oseiskar/CE-inertial/PCBs/design-files/RPi-Pico/pico_extension_v1_1.png

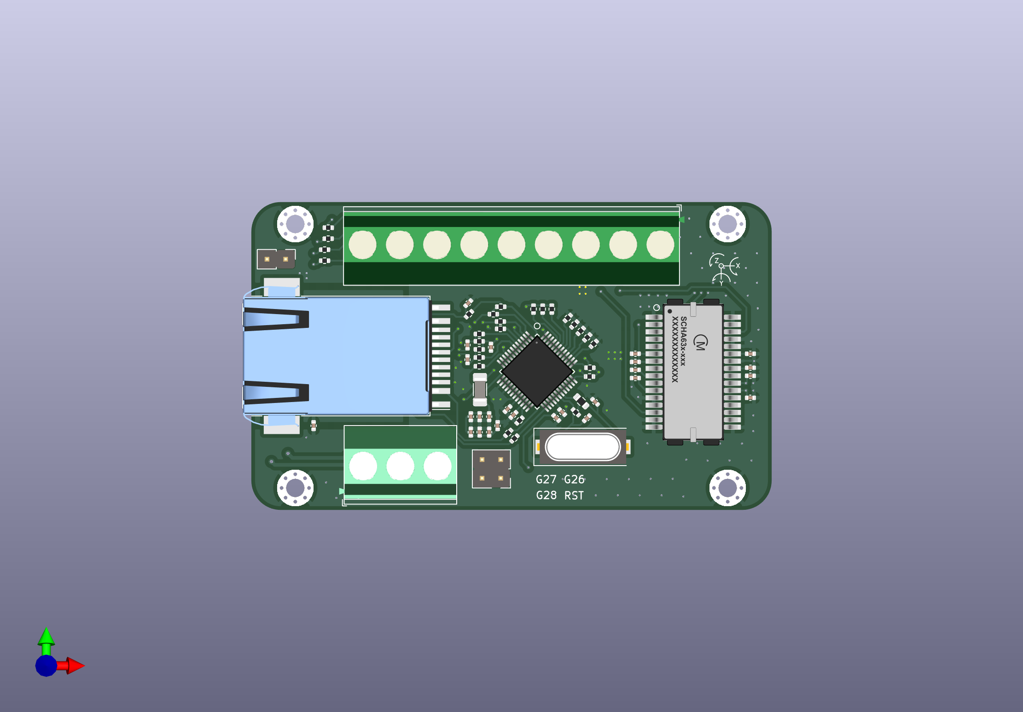
PCBs/design-files/RPi-Pico/pico_extension_v1_1.png
