oseiskar/CE-inertial/drivers/README.md

# Murata SCHA6XX drivers

Implementations for Arduino and RPi Pico platforms
