oseiskar/CE-inertial/PCBs/README.md

# Inertial Module PCBs

NOTE: designs have not been proven to work and should be checked before ordering prototypes. 

Design files and libraries required for two Raspberry Pico implementations.
