oseiskar/CE-inertial/drivers/arduino/README.md

# Murata SCHA63x driver for Arduino

Simple driver for the Murata SCHA63X series of IMUs for the Arduino board. The full data sheet for the sensor can be requested from [Murata](https://www.murata.com/en-global/products/sensor/gyro/overview/lineup/scha63t). SPI is used for communication between the sensor and the Arduino board. The carrier PCB documentation is available [here](https://www.murata.com/-/media/webrenewal/products/sensor/pdf/specification/scha600_series_chip-carrier_pcb_specification.ashx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). 

## Resources

* [Arduino SPI Library & example](https://www.arduino.cc/en/reference/SPI)
* [InvenSense ICM-20948 example](https://github.com/sparkfun/SparkFun_ICM-20948_ArduinoLibrary)
