oseiskar/CE-inertial/drivers/pico/scha-driver/README.md

# Pico SCHA6XX Driver

Ethernet communication and protocolbuffer code not included
