oseiskar/CE-inertial/PCBs/custom/ethernet/cetus/J1B1211CCD.step

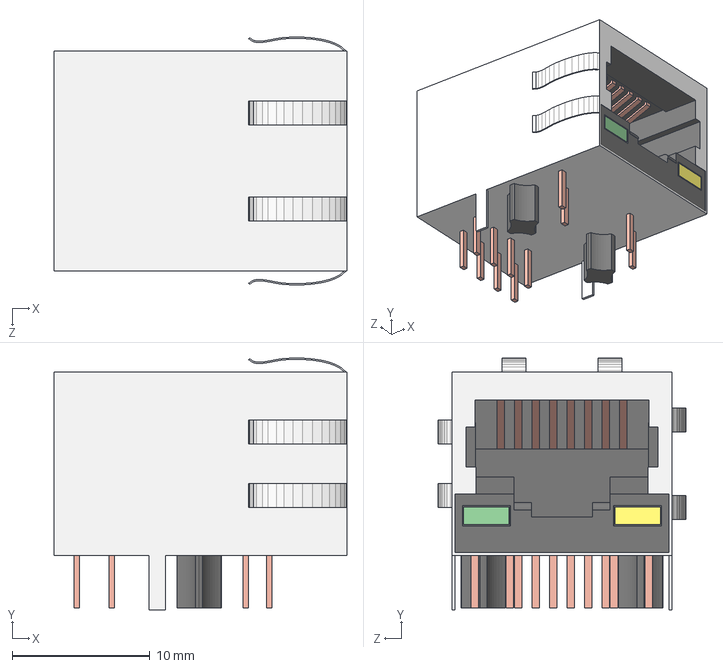
[picture p2: CAD file, 2022-09-22]
PCBs/custom/ethernet/cetus/J1B1211CCD.step
21.3 x 18.3 x 18.0 mm
