oseiskar/CE-inertial/PCBs/custom/ethernet/wiznet/wiznet/Wiznet_W5500.stp

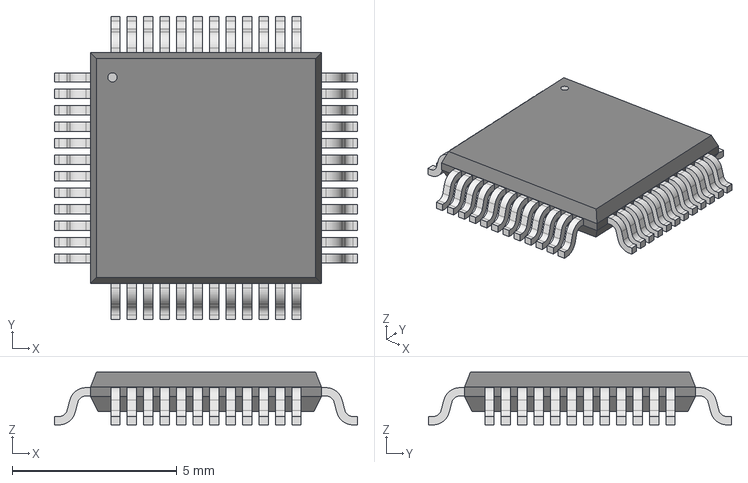
[picture p3: CAD file, 2022-09-22]
PCBs/custom/ethernet/wiznet/wiznet/Wiznet_W5500.stp
9.19 x 9.19 x 1.60 mm
