oseiskar/CE-inertial/PCBs/custom/ethernet/wuerth/wuerth/Wuerth_74980111211.stp

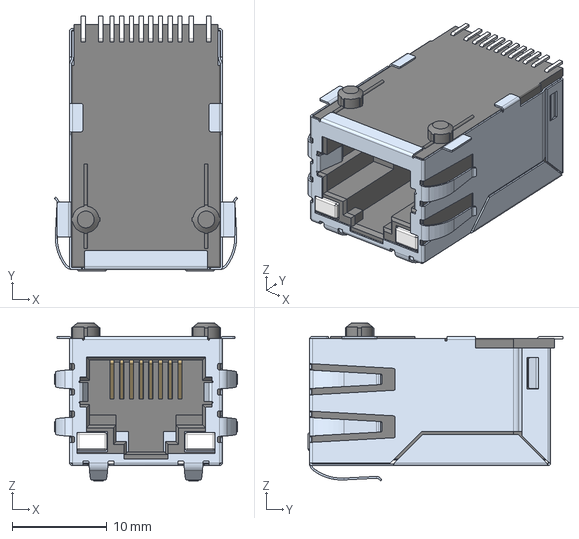
[picture p4: CAD file, 2022-09-22]
PCBs/custom/ethernet/wuerth/wuerth/Wuerth_74980111211.stp
19.3 x 26.9 x 16.6 mm
Insulator x 3
shielding
