oseiskar/CE-inertial/PCBs/custom/murata/murata/scha.step

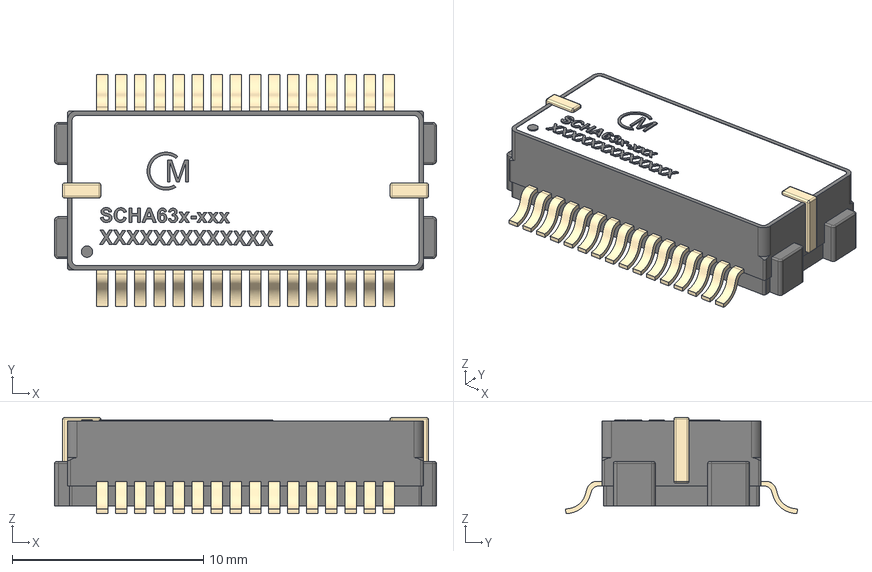
[picture p6: CAD file, 2022-09-22]
PCBs/custom/murata/murata/scha.step
20.0 x 12.2 x 5.05 mm
imu_body
feet
front_plate
graphicst
