oseiskar/CE-inertial/PCBs/custom/terminal/TerminalBlock_Phoenix_MKDS-1,5-3-5.08_1x03_P5.08mm_Horizontal.step

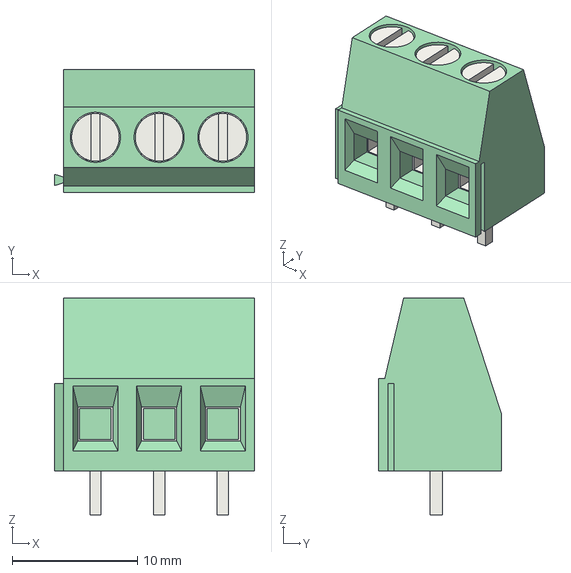
[picture p7: CAD file, 2022-09-22]
PCBs/custom/terminal/TerminalBlock_Phoenix_MKDS-1,5-3-5.08_1x03_P5.08mm_Horizontal.step
16.0 x 9.80 x 17.3 mm
