oseiskar/CE-inertial/PCBs/custom/mcu/w5500-pico-evb/PinHeader_1x06_P2.54mm_Vertical.step

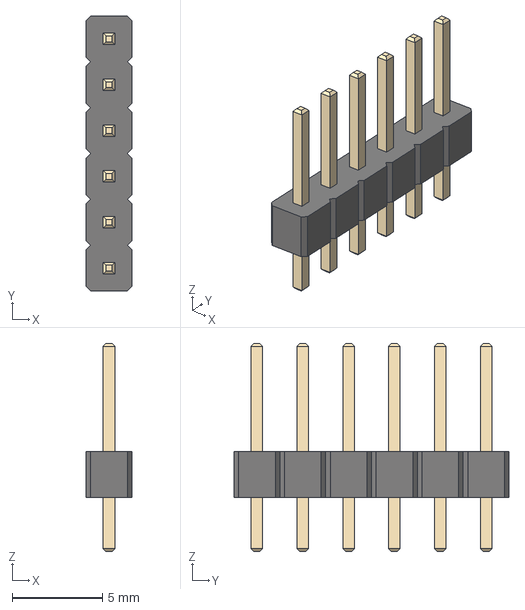
[picture p8: CAD file, 2022-09-22]
PCBs/custom/mcu/w5500-pico-evb/PinHeader_1x06_P2.54mm_Vertical.step
2.54 x 15.2 x 11.5 mm
