oseiskar/CE-inertial/PCBs/custom/terminal/TerminalBlock_Phoenix_MKDS-1,5-9-5.08_1x09_P5.08mm_Horizontal.step

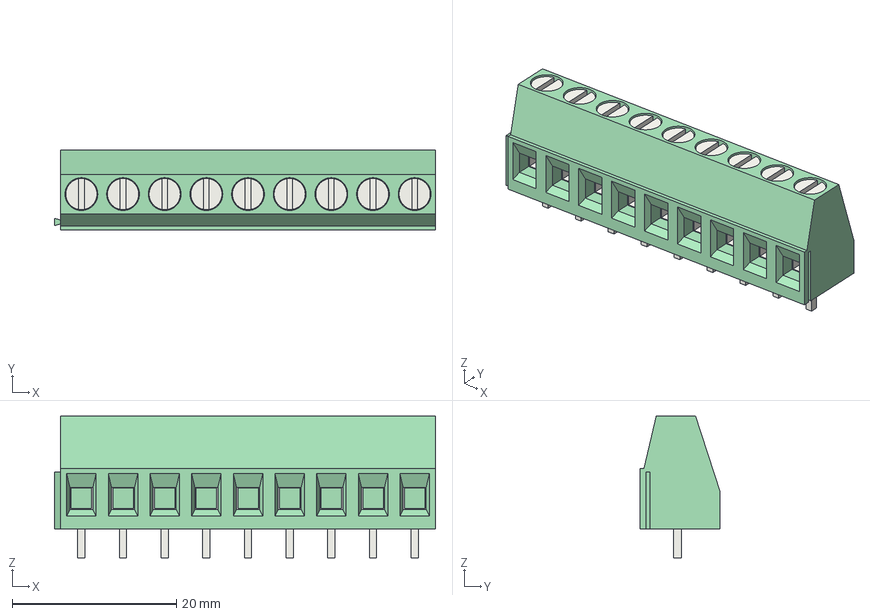
[picture p9: CAD file, 2022-09-22]
PCBs/custom/terminal/TerminalBlock_Phoenix_MKDS-1,5-9-5.08_1x09_P5.08mm_Horizontal.step
46.5 x 9.80 x 17.3 mm
