oseiskar/CE-inertial/PCBs/custom/mcu/w5500-pico-evb/pico.step

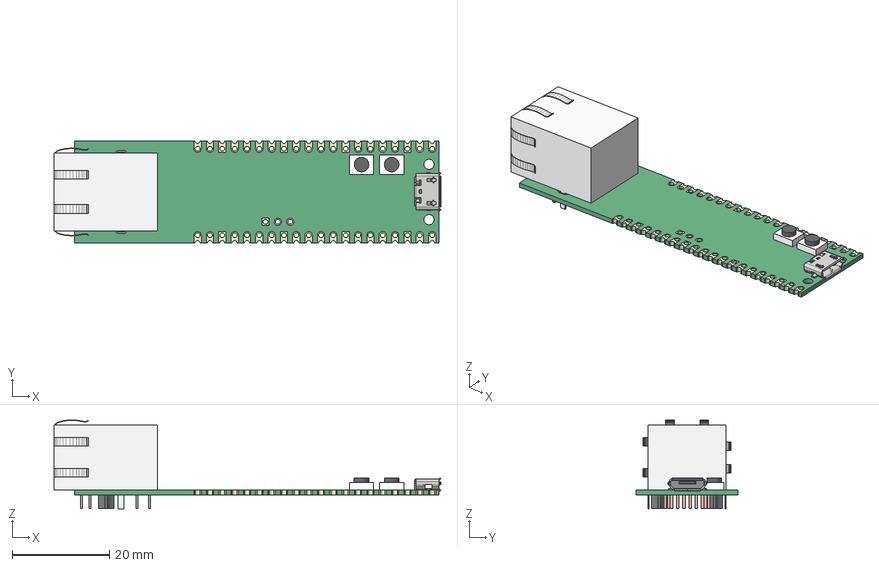
[picture p10: CAD file, 2022-09-22]
PCBs/custom/mcu/w5500-pico-evb/pico.step
79.6 x 21.0 x 18.3 mm
pins
J1B1211CCD
molex_0473460001
buttons
board
