oseiskar/CE-inertial/PCBs/custom/mcu/w5500-pico-evb/PinHeader_1x20_P2.54mm_Vertical.step

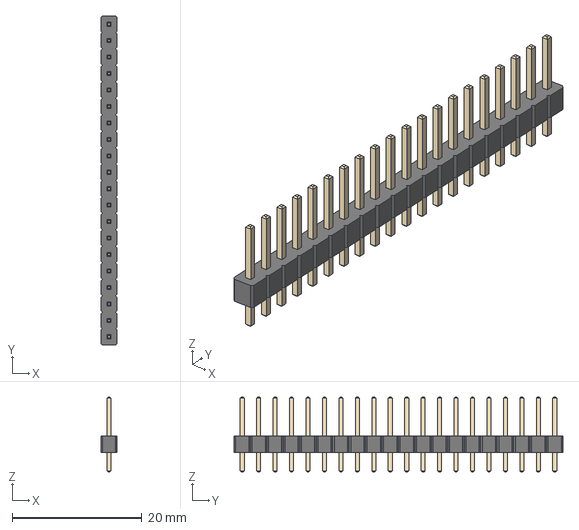
[picture p11: CAD file, 2022-09-22]
PCBs/custom/mcu/w5500-pico-evb/PinHeader_1x20_P2.54mm_Vertical.step
2.54 x 50.8 x 11.5 mm
