oseiskar/CE-inertial/(list of files, cad)

Other CAD files:
PCBs/custom/mcu/w5500-pico-evb/pico_evb.step
PCBs/custom/murata/murata/scha_.step
