oseiskar/CE-inertial/PCBs/schema/W5500-Pico.pdf

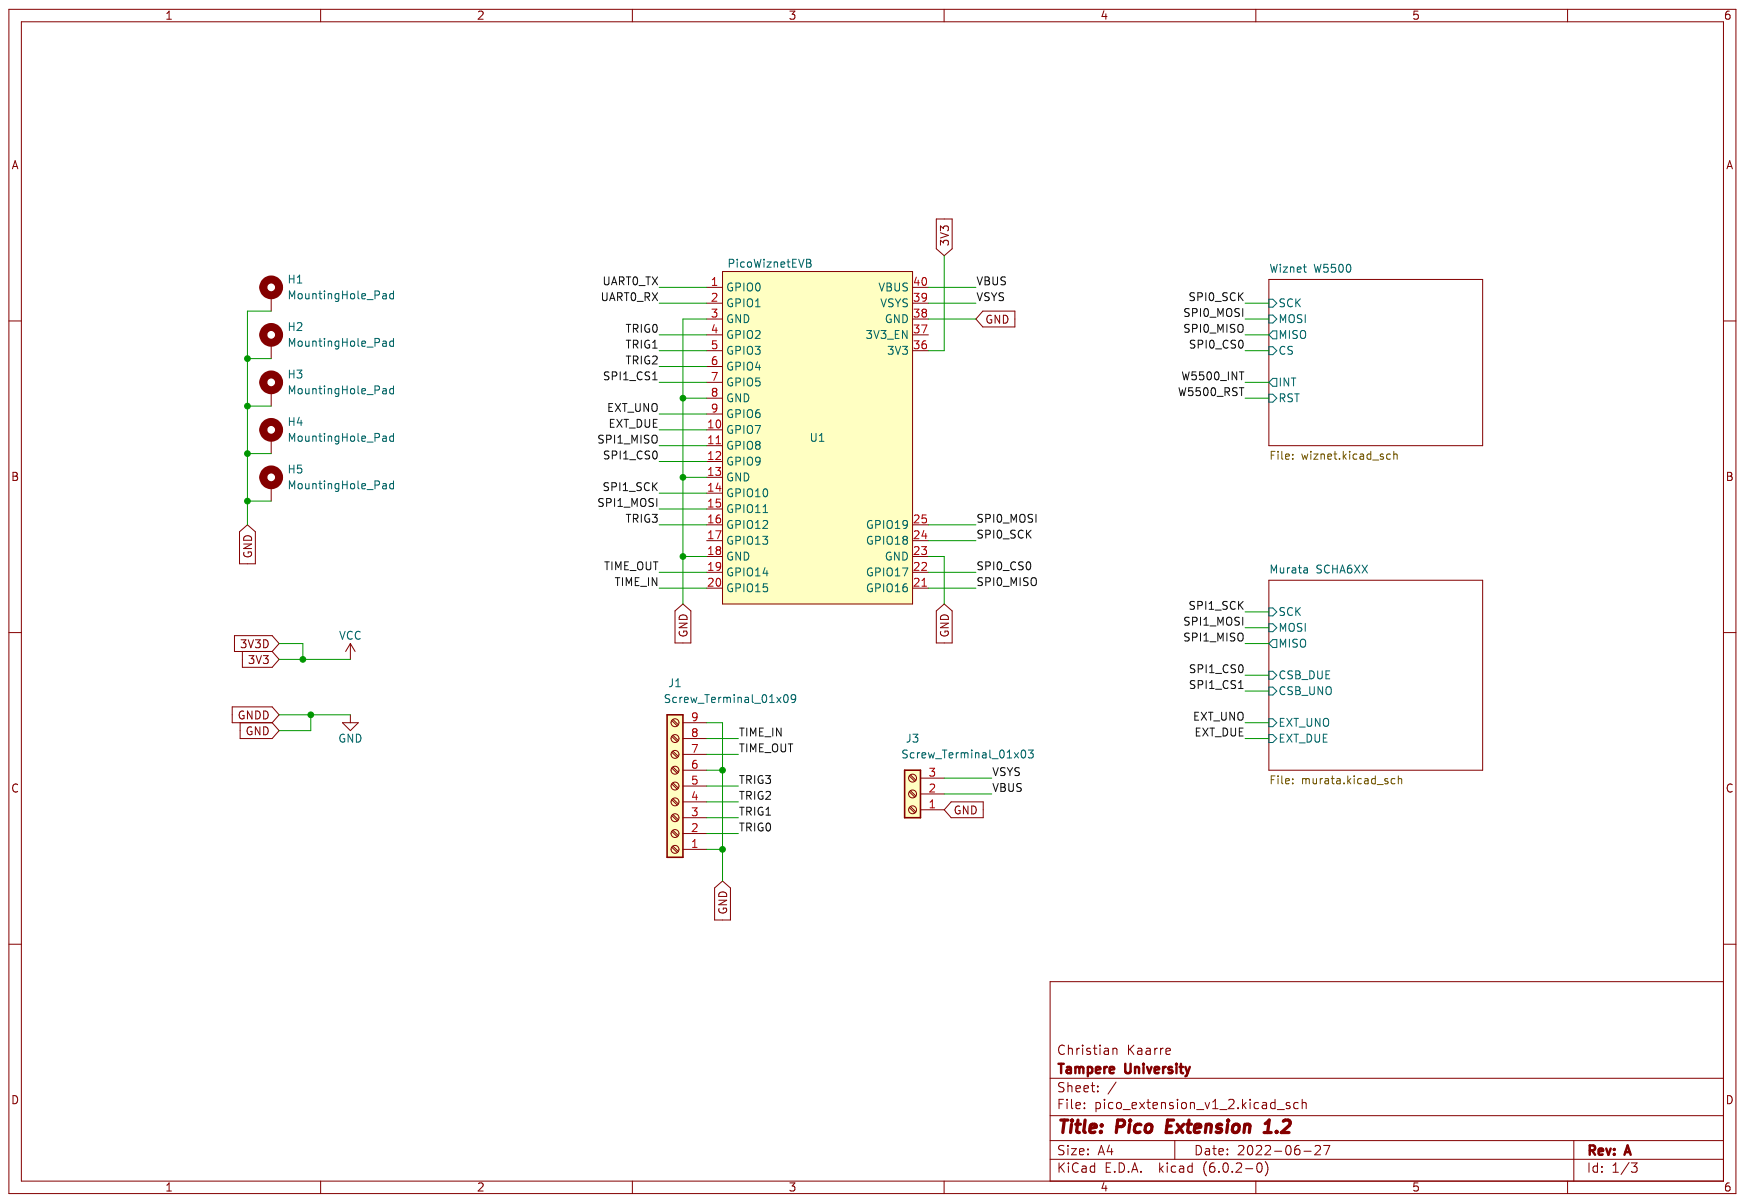
[picture p15: page 1]

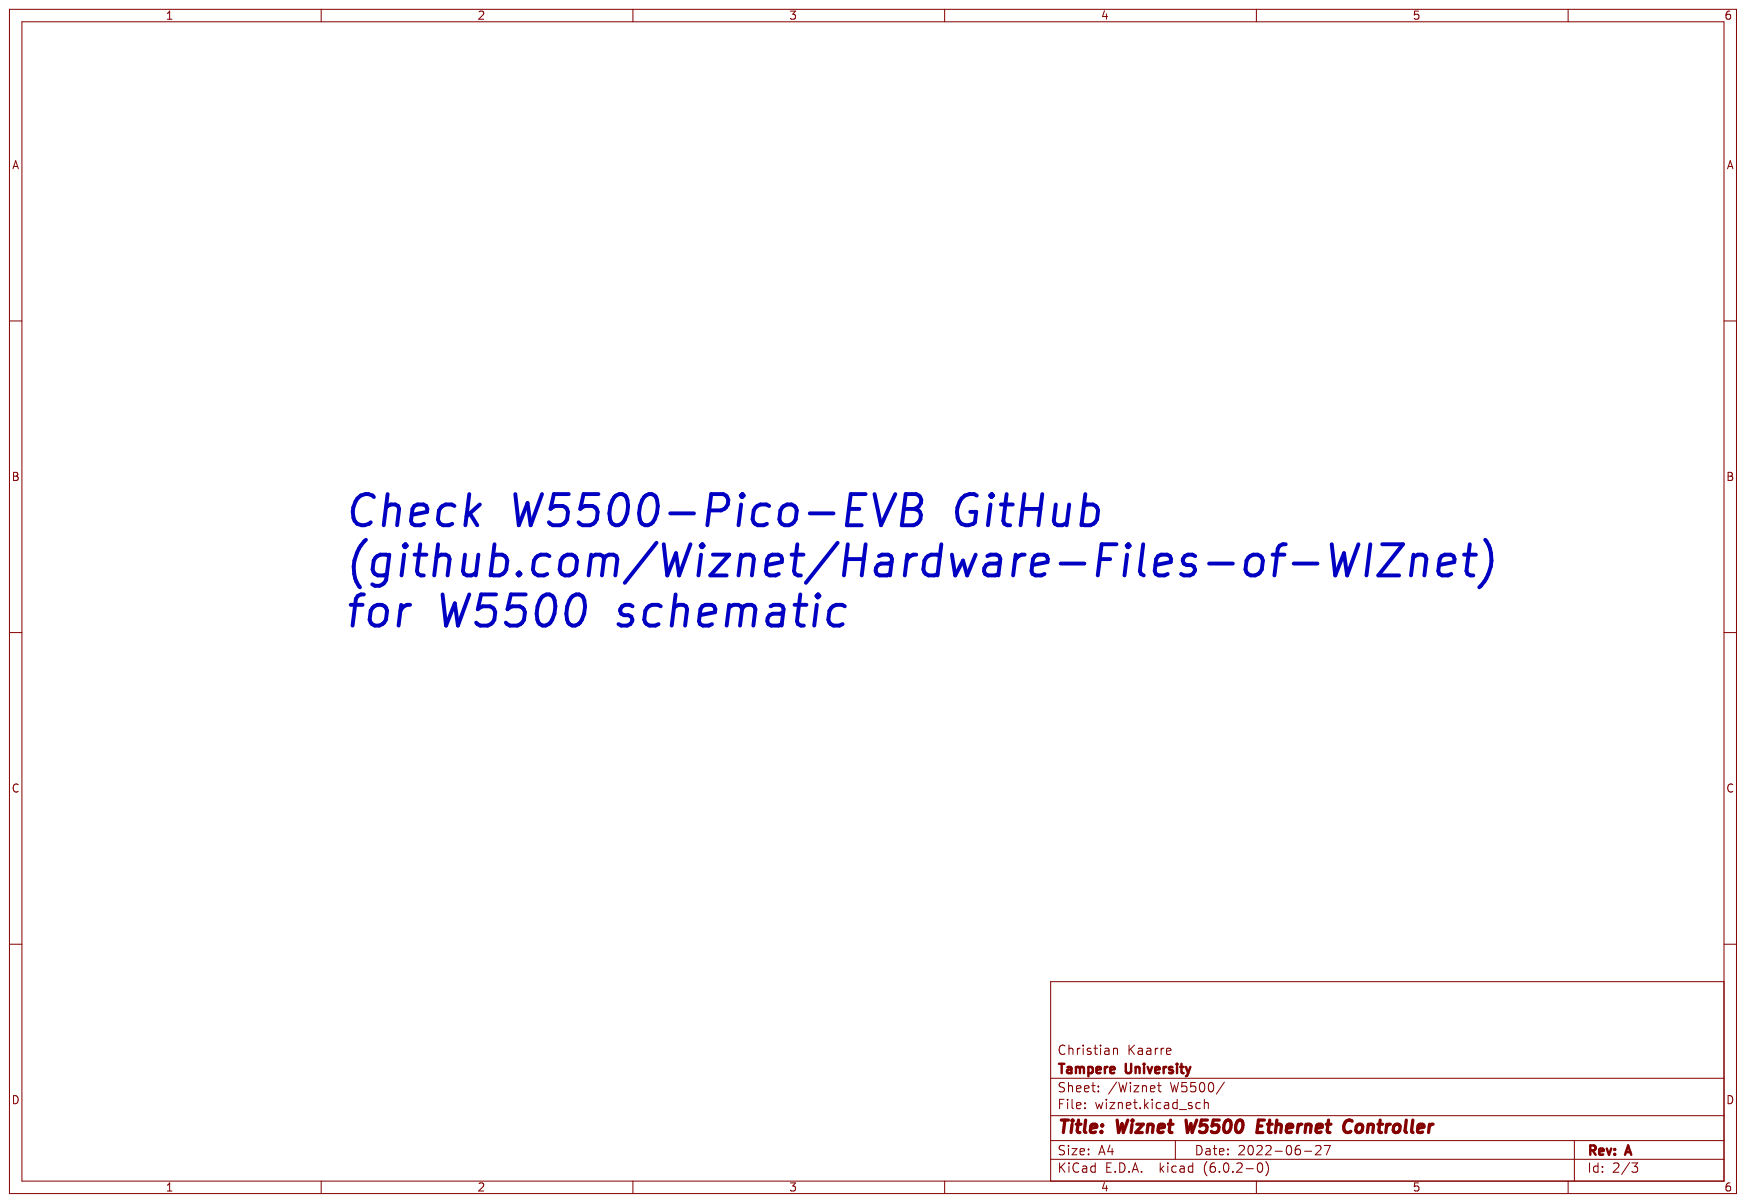
[picture p16: page 2]
