oseiskar/CE-inertial/PCBs/design-files/W5500-Pico/pico_extension_v1_2.kicad_pcb

## KiCad design PCBs/design-files/W5500-Pico/pico_extension_v1_2.kicad_pcb (2022-09-22)

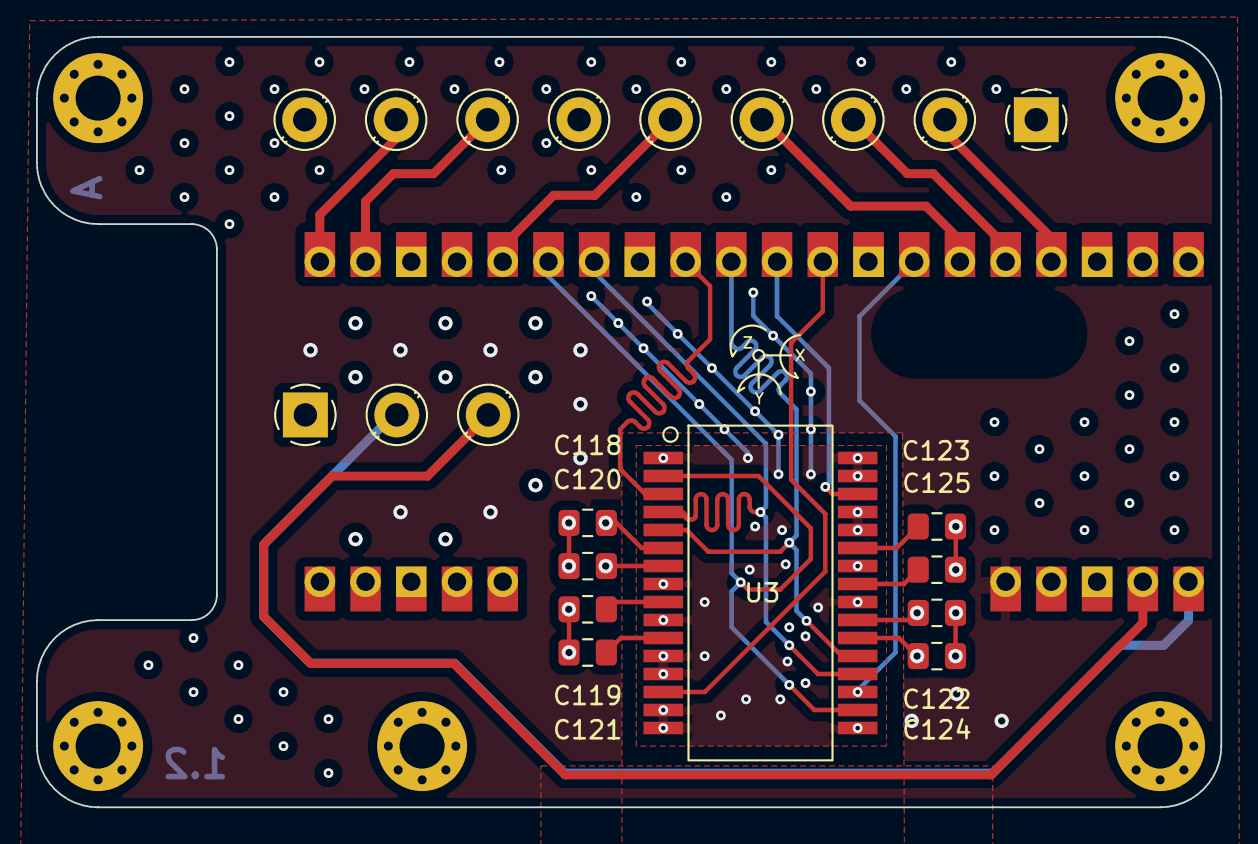
[picture p17: board pico_extension_v1_2.kicad_pcb from above]

Board: 4 copper layers, 65.8 x 42.8 mm, 17 parts (0 on the bottom side), 21 nets.

Parts:
C118, C119, C121, C122, C123, C125: 1uF; C_0805_2012Metric_Pad1.18x1.45mm_HandSolder
C120, C124: 100nF; C_0805_2012Metric_Pad1.18x1.45mm_HandSolder
H1, H2, H3, H4, H5: MountingHole_Pad; MountingHole_2.5mm_Pad_Via
J1: Screw_Terminal_01x09; TerminalBlock_RND_205-00294_1x09_P5.08mm_Horizontal
J3: Screw_Terminal_01x03; TerminalBlock_RND_205-00288_1x03_P5.08mm_Horizontal
U1: PicoWiznetEVB; pico-w5500-evb-limited_pins
U3: SCHA63X; murata_scha

Connections:
3V3: C118.1, C120.1, C122.1, C124.1, U1.36 (3V3), U3.6 (DUE_V3p3D), U3.7 (DUE_V3p3A), U3.22 (UNO_V3p3D), U3.23 (UNO_V3p3A)
/EXT_DUE: U1.10 (GPIO7), U3.30 (DUE_TI/EXTERN)
/EXT_UNO: U1.9 (GPIO6), U3.14 (UNO_TI/EXTERN)
/SPI1_CS0: U1.12 (GPIO9), U3.3 (DUE_CSB)
/SPI1_CS1: U1.7 (GPIO5), U3.19 (UNO_CSB)
/SPI1_MISO: U1.11 (GPIO8), U3.5 (DUE_MISO), U3.21 (UNO_MISO)
/SPI1_MOSI: U1.15 (GPIO11), U3.2 (DUE_MOSI), U3.18 (UNO_MOSI)
/SPI1_SCK: U1.14 (GPIO10), U3.4 (DUE_SCK), U3.20 (UNO_SCK)
/TIME_IN: J1.8, U1.20 (GPIO15)
/TIME_OUT: J1.7, U1.19 (GPIO14)
/TRIG0: J1.2, U1.4 (GPIO2)
/TRIG1: J1.3, U1.5 (GPIO3)
/TRIG2: J1.4, U1.6 (GPIO4)
/TRIG3: J1.5, U1.16 (GPIO12)
/VBUS: J3.2, U1.40 (VBUS)
/VSYS: J3.3, U1.39 (VSYS)
GND: C118.2, C119.1, C120.2, C121.1, C122.2, C123.2, C124.2, C125.2, H1.1, H2.1, H3.1, H4.1, H5.1, J1.1, J1.6, J1.9, J3.1, U1.3 (GND), U1.8 (GND), U1.13 (GND), U1.18 (GND), U1.23 (GND), U1.38 (GND), U3.1 (EMC_GND), U3.8 (DUE_GNDD), U3.10 (UNO_GNDA/EMC_GND), U3.12 (RESERVED), U3.13 (UNO_TIOP), U3.15 (UNO_TION), U3.16 (EMC_GND), U3.17 (EMC_GND), U3.24 (UNO_GNDD), U3.26 (DUE_GNDA/EMC_GND), U3.28 (DUE_RESERVED), U3.29 (DUE_TIOP), U3.31 (DUE_TION), U3.32 (EMC_GND)
unnamed: C119.2, U3.9 (DUE_VDDD)
unnamed: C121.2, U3.11 (UNO_VDDA)
unnamed: C123.1, U3.27 (DUE_VDDA)
unnamed: C125.1, U3.25 (UNO_VDDD)
