oseiskar/CE-inertial/PCBs/design-files/RPi-Pico/pico_extension_v1_1.kicad_pcb

## KiCad design PCBs/design-files/RPi-Pico/pico_extension_v1_1.kicad_pcb (2022-09-22)

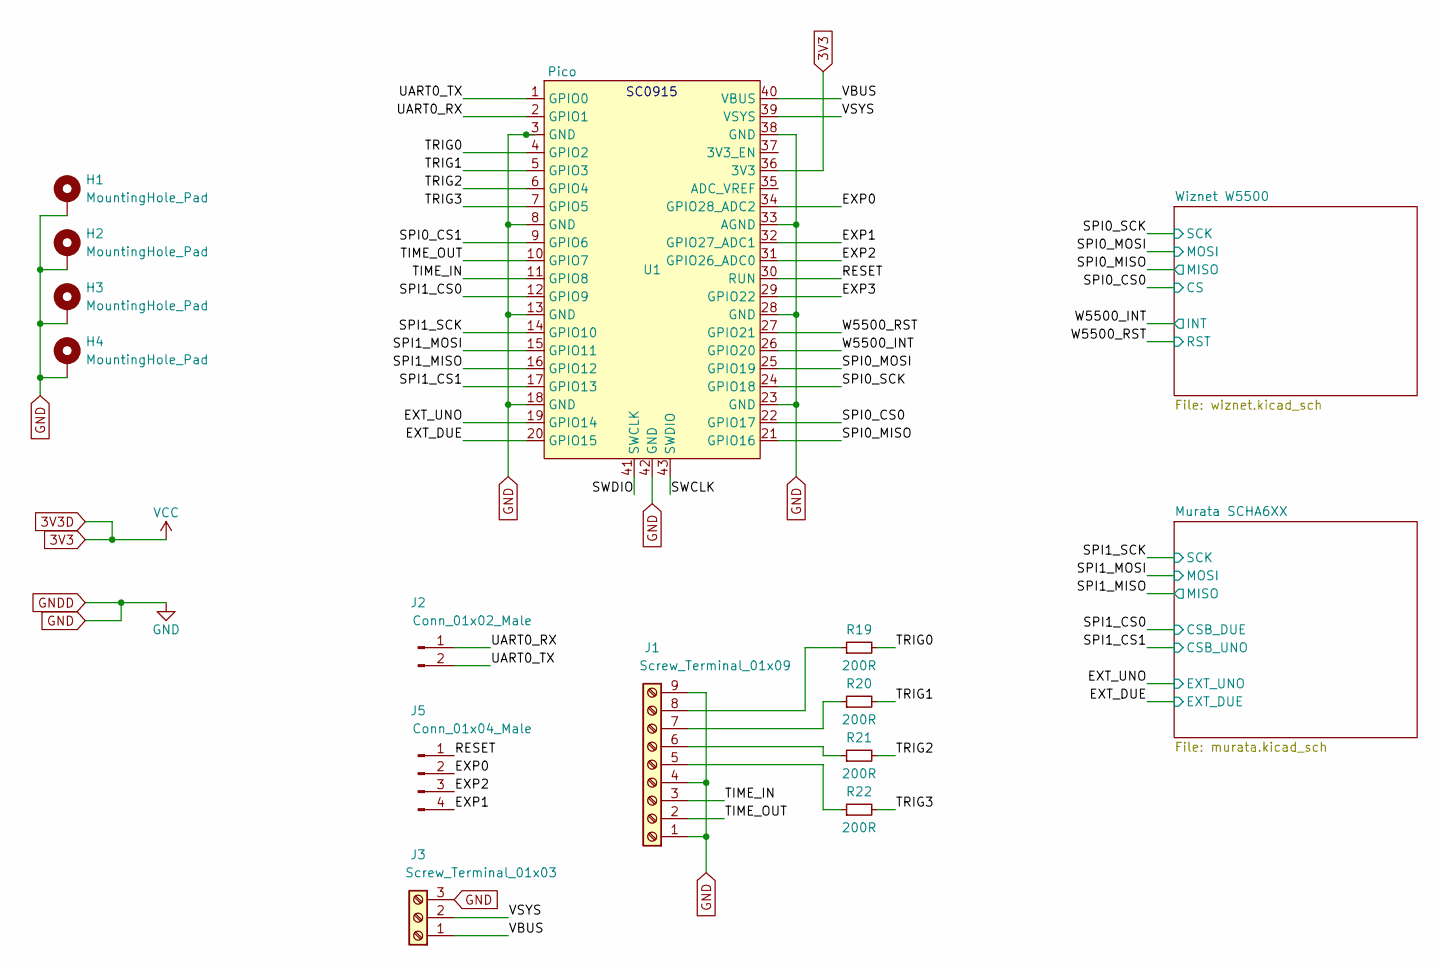
[picture p18: schematic pico_extension_v1_1.kicad_sch, Pico Extension v1.1]

Parts:
H1, H2, H3, H4: MountingHole_Pad; MountingHole_2.5mm_Pad_Via
J1: Screw_Terminal_01x09; TerminalBlock_RND_205-00294_1x09_P5.08mm_Horizontal
J2: Conn_01x02_Male; PinHeader_1x02_P2.54mm_Vertical
J3: Screw_Terminal_01x03; TerminalBlock_RND_205-00288_1x03_P5.08mm_Horizontal
J5: Conn_01x04_Male; PinHeader_2x02_P2.54mm_Vertical
R19, R20, R21, R22: 200R; R_0402_1005Metric; LCSC C25087
U1: Pico; RPi_Pico_SMD_nopins

Connections:
3V3: U1.36 (3V3); also elsewhere on the board
/EXP0: J5.2, U1.34 (GPIO28_ADC2)
/EXP1: J5.4, U1.32 (GPIO27_ADC1)
/EXP2: J5.3, U1.31 (GPIO26_ADC0)
/EXP3: U1.29 (GPIO22)
/EXT_DUE: U1.20 (GPIO15); also elsewhere on the board
/EXT_UNO: U1.19 (GPIO14); also elsewhere on the board
/RESET: J5.1, U1.30 (RUN)
/SPI0_CS0: U1.22 (GPIO17); also elsewhere on the board
/SPI0_CS1: U1.9 (GPIO6)
/SPI0_MISO: U1.21 (GPIO16); also elsewhere on the board
/SPI0_MOSI: U1.25 (GPIO19); also elsewhere on the board
/SPI0_SCK: U1.24 (GPIO18); also elsewhere on the board
/SPI1_CS0: U1.12 (GPIO9); also elsewhere on the board
/SPI1_CS1: U1.17 (GPIO13); also elsewhere on the board
/SPI1_MISO: U1.16 (GPIO12); also elsewhere on the board
/SPI1_MOSI: U1.15 (GPIO11); also elsewhere on the board
/SPI1_SCK: U1.14 (GPIO10); also elsewhere on the board
/SWCLK: U1.43 (SWDIO)
/SWDIO: U1.41 (SWCLK)
/TIME_IN: J1.3, U1.11 (GPIO8)
/TIME_OUT: J1.2, U1.10 (GPIO7)
/TRIG0: R19.2, U1.4 (GPIO2)
/TRIG1: R20.2, U1.5 (GPIO3)
/TRIG2: R21.2, U1.6 (GPIO4)
/TRIG3: R22.2, U1.7 (GPIO5)
/UART0_RX: J2.1, U1.2 (GPIO1)
/UART0_TX: J2.2, U1.1 (GPIO0)
/VBUS: J3.1, U1.40 (VBUS)
/VSYS: J3.2, U1.39 (VSYS)
/W5500_INT: U1.26 (GPIO20); also elsewhere on the board
/W5500_RST: U1.27 (GPIO21); also elsewhere on the board
GND: H1.1, H2.1, H3.1, H4.1, J1.1, J1.4, J1.9, J3.3, U1.3 (GND), U1.8 (GND), U1.13 (GND), U1.18 (GND), U1.23 (GND), U1.28 (GND), U1.33 (AGND), U1.38 (GND), U1.42 (GND); also elsewhere on the board
unnamed: J1.5, R22.1
unnamed: J1.6, R21.1
unnamed: J1.7, R20.1
unnamed: J1.8, R19.1

Notes on the sheet:
SC0915

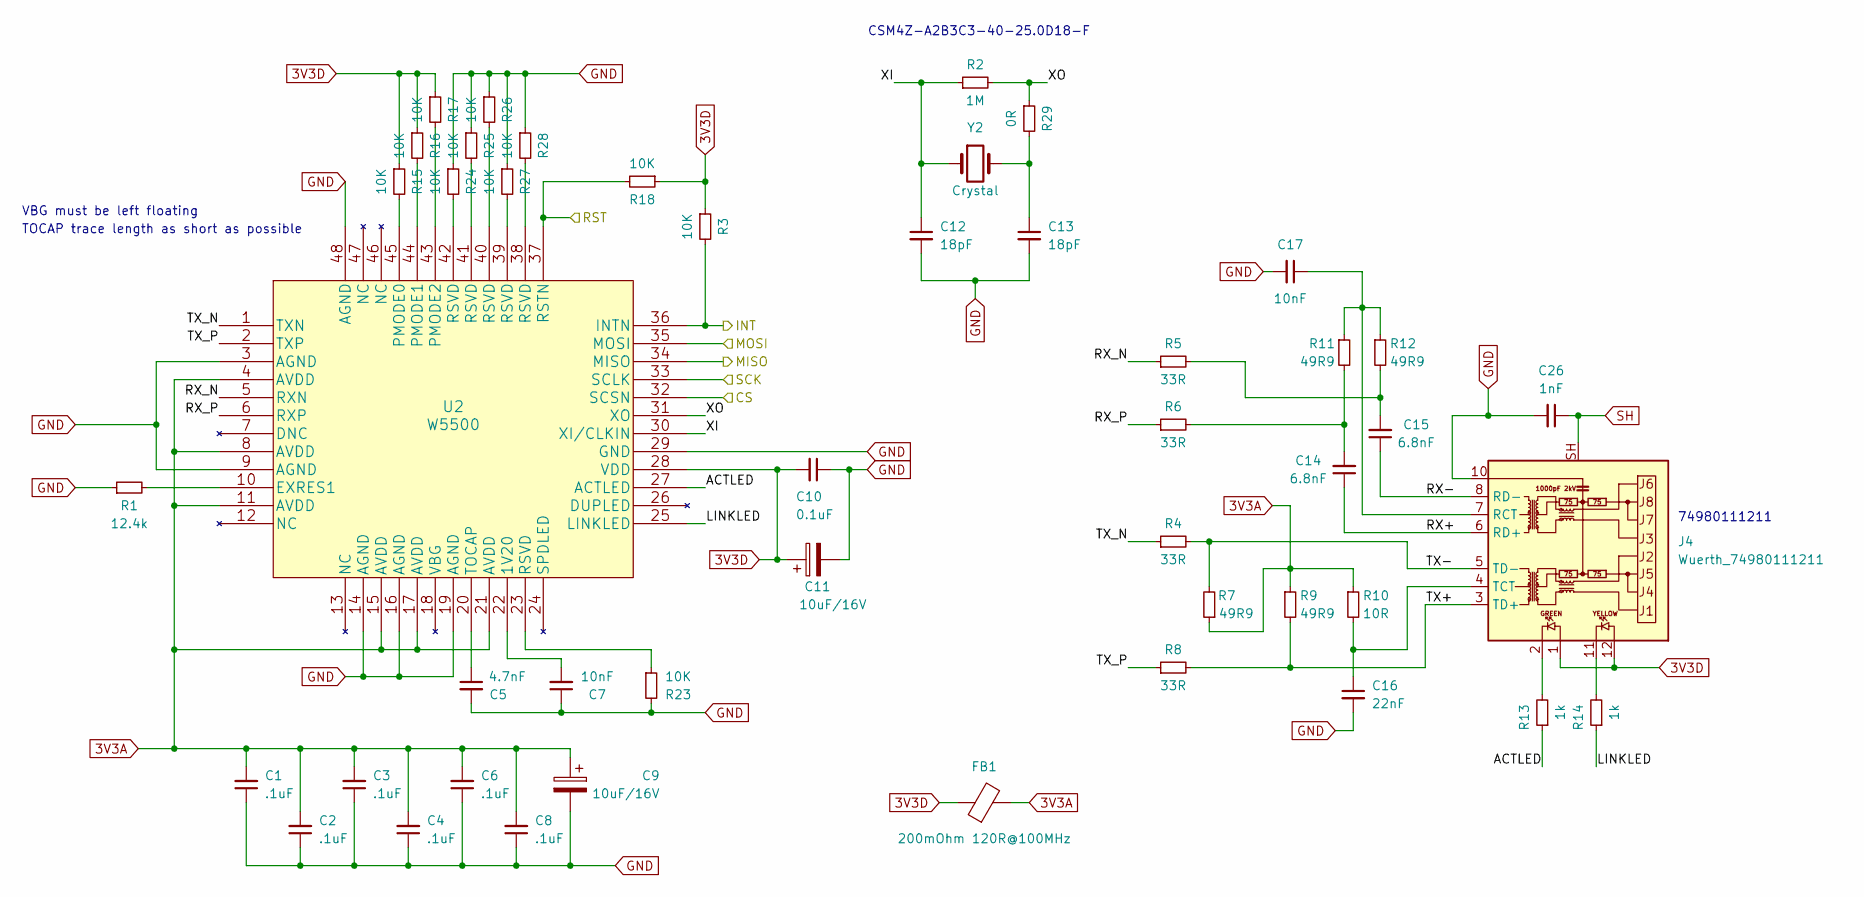
[picture p19: schematic wiznet.kicad_sch, Wiznet W5500 Ethernet Controller]

Parts:
C1, C2, C3, C4, C6, C8: .1uF; C_0402_1005Metric; LCSC C1546
C5: 4.7nF; C_0402_1005Metric; LCSC C1538
C7, C17: 10nF; C_0402_1005Metric; LCSC C15195
C9, C11: 10uF/16V; C_0402_1005Metric; LCSC C15525
C10: 0.1uF; C_0402_1005Metric; LCSC C1546
C12, C13: 18pF; C_0402_1005Metric; LCSC C1549
C14, C15: 6.8nF; C_0402_1005Metric; LCSC C1576
C16: 22nF; C_0402_1005Metric; LCSC C1532
C26: 1nF; C_0402_1005Metric; LCSC C1523
FB1: 200mOhm 120R@100MHz; L_1206_3216Metric_Pad1.22x1.90mm_HandSolder; LCSC C85841
J4: Wuerth_74980111211; RJ45_Wuerth_74980111211_h
R1: 12.4k; R_0402_1005Metric; LCSC C325375
R2: 1M; R_0402_1005Metric; LCSC C26083
R3, R15, R16, R17, R18, R23, R24, R25, R26, R27, R28: 10K; R_0402_1005Metric; LCSC C25744
R4, R5, R6, R8: 33R; R_0402_1005Metric; LCSC C138002
R7, R9, R11, R12: 49R9; R_0402_1005Metric; LCSC C144754
R10: 10R; R_0402_1005Metric; LCSC C176108
R13, R14: 1k; R_0402_1005Metric; LCSC C11702
R29: 0R; R_0603_1608Metric; LCSC C21189
U2: W5500; w5500; LCSC C32843
Y2: Crystal; Crystal_SMD_HC49-SD; LCSC C390751

Connections:
3V3: C10.2, C11.1, FB1.1, J4.1, J4.12, R3.1, R15.1, R16.1, R17.1, R18.1, U2.28 (VDD); also elsewhere on the board
3V3A: C1.2, C2.2, C3.2, C4.2, C6.2, C8.2, C9.1, FB1.2, R7.1, R9.1, R10.1, U2.4 (AVDD), U2.8 (AVDD), U2.11 (AVDD), U2.15 (AVDD), U2.17 (AVDD), U2.21 (AVDD)
/SPI0_CS0: U2.32 (SCSN); also elsewhere on the board
/SPI0_MISO: U2.34 (MISO); also elsewhere on the board
/SPI0_MOSI: U2.35 (MOSI); also elsewhere on the board
/SPI0_SCK: U2.33 (SCLK); also elsewhere on the board
/W5500_INT: R3.2, U2.36 (INTN); also elsewhere on the board
/W5500_RST: R18.2, U2.37 (RSTN); also elsewhere on the board
/Wiznet W5500/ACTLED: R13.1, U2.27 (ACTLED)
/Wiznet W5500/LINKLED: R14.1, U2.25 (LINKLED)
/Wiznet W5500/RX+: C14.1, J4.6 (RD+)
/Wiznet W5500/RX-: C15.1, J4.8 (RD-)
/Wiznet W5500/RX_N: R5.1, U2.5 (RXN)
/Wiznet W5500/RX_P: R6.1, U2.6 (RXP)
/Wiznet W5500/TX+: J4.3 (TD+), R8.2, R9.2
/Wiznet W5500/TX-: J4.5 (TD-), R4.2, R7.2
/Wiznet W5500/TX_N: R4.1, U2.1 (TXN)
/Wiznet W5500/TX_P: R8.1, U2.2 (TXP)
/Wiznet W5500/XI: C12.1, R2.1, U2.30 (XI/CLKIN), Y2.1
/Wiznet W5500/XO: R2.2, R29.1, U2.31 (XO)
GND: C1.1, C2.1, C3.1, C4.1, C5.2, C6.1, C7.1, C8.1, C9.2, C10.1, C11.2, C12.2, C13.2, C16.2, C17.2, C26.2, J4.10, R1.1, R23.2, R24.1, R25.1, R26.1, R27.1, R28.1, U2.3 (AGND), U2.9 (AGND), U2.14 (AGND), U2.16 (AGND), U2.19 (AGND), U2.29 (GND), U2.48 (AGND); also elsewhere on the board
unnamed: C5.1, U2.20 (TOCAP)
unnamed: C7.2, U2.22 (1V20)
unnamed: C13.1, R29.2, Y2.2
unnamed: C14.2, R6.2, R11.2
unnamed: C15.2, R5.2, R12.2
unnamed: C16.1, J4.4 (TCT), R10.2
unnamed: C17.1, J4.7 (RCT), R11.1, R12.1
unnamed: J4.2, R13.2
unnamed: J4.11, R14.2
unnamed: R1.2, U2.10 (EXRES1)
unnamed: R15.2, U2.45 (PMODE0)
unnamed: R16.2, U2.44 (PMODE1)
unnamed: R17.2, U2.43 (PMODE2)
unnamed: R23.1, U2.23 (RSVD)
unnamed: R24.2, U2.42 (RSVD)
unnamed: R25.2, U2.41 (RSVD)
unnamed: R26.2, U2.40 (RSVD)
unnamed: R27.2, U2.39 (RSVD)
unnamed: R28.2, U2.38 (RSVD)
SH: C26.1, J4.SH

Notes on the sheet:
CSM4Z-A2B3C3-40-25.0D18-F
VBG must be left floating
TOCAP trace length as short as possible
74980111211

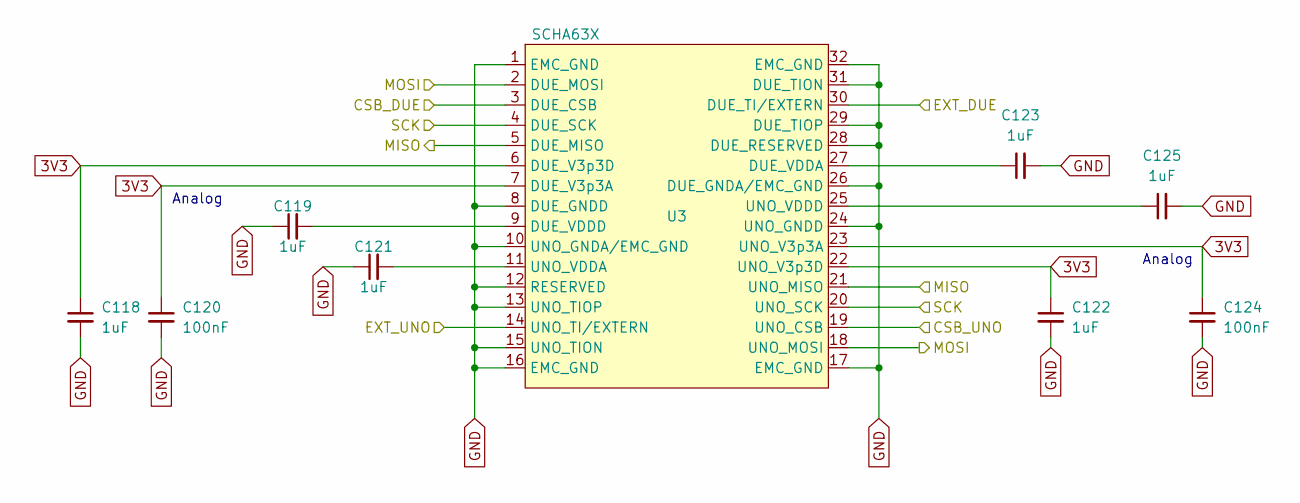
[picture p20: schematic murata.kicad_sch, Murata SCHA6XX]

Parts:
C118, C119, C121, C122, C123, C125: 1uF; C_0402_1005Metric; LCSC C52923
C120, C124: 100nF; C_0402_1005Metric; LCSC C1525
U3: SCHA63X; murata_scha

Connections:
3V3: C118.1, C120.1, C122.1, C124.1, U3.6 (DUE_V3p3D), U3.7 (DUE_V3p3A), U3.22 (UNO_V3p3D), U3.23 (UNO_V3p3A); also elsewhere on the board
/EXT_DUE: U3.30 (DUE_TI/EXTERN); also elsewhere on the board
/EXT_UNO: U3.14 (UNO_TI/EXTERN); also elsewhere on the board
/SPI1_CS0: U3.3 (DUE_CSB); also elsewhere on the board
/SPI1_CS1: U3.19 (UNO_CSB); also elsewhere on the board
/SPI1_MISO: U3.5 (DUE_MISO), U3.21 (UNO_MISO); also elsewhere on the board
/SPI1_MOSI: U3.2 (DUE_MOSI), U3.18 (UNO_MOSI); also elsewhere on the board
/SPI1_SCK: U3.4 (DUE_SCK), U3.20 (UNO_SCK); also elsewhere on the board
GND: C118.2, C119.1, C120.2, C121.1, C122.2, C123.2, C124.2, C125.2, U3.1 (EMC_GND), U3.8 (DUE_GNDD), U3.10 (UNO_GNDA/EMC_GND), U3.12 (RESERVED), U3.13 (UNO_TIOP), U3.15 (UNO_TION), U3.16 (EMC_GND), U3.17 (EMC_GND), U3.24 (UNO_GNDD), U3.26 (DUE_GNDA/EMC_GND), U3.28 (DUE_RESERVED), U3.29 (DUE_TIOP), U3.31 (DUE_TION), U3.32 (EMC_GND); also elsewhere on the board
unnamed: C119.2, U3.9 (DUE_VDDD)
unnamed: C121.2, U3.11 (UNO_VDDA)
unnamed: C123.1, U3.27 (DUE_VDDA)
unnamed: C125.1, U3.25 (UNO_VDDD)

Notes on the sheet:
Analog

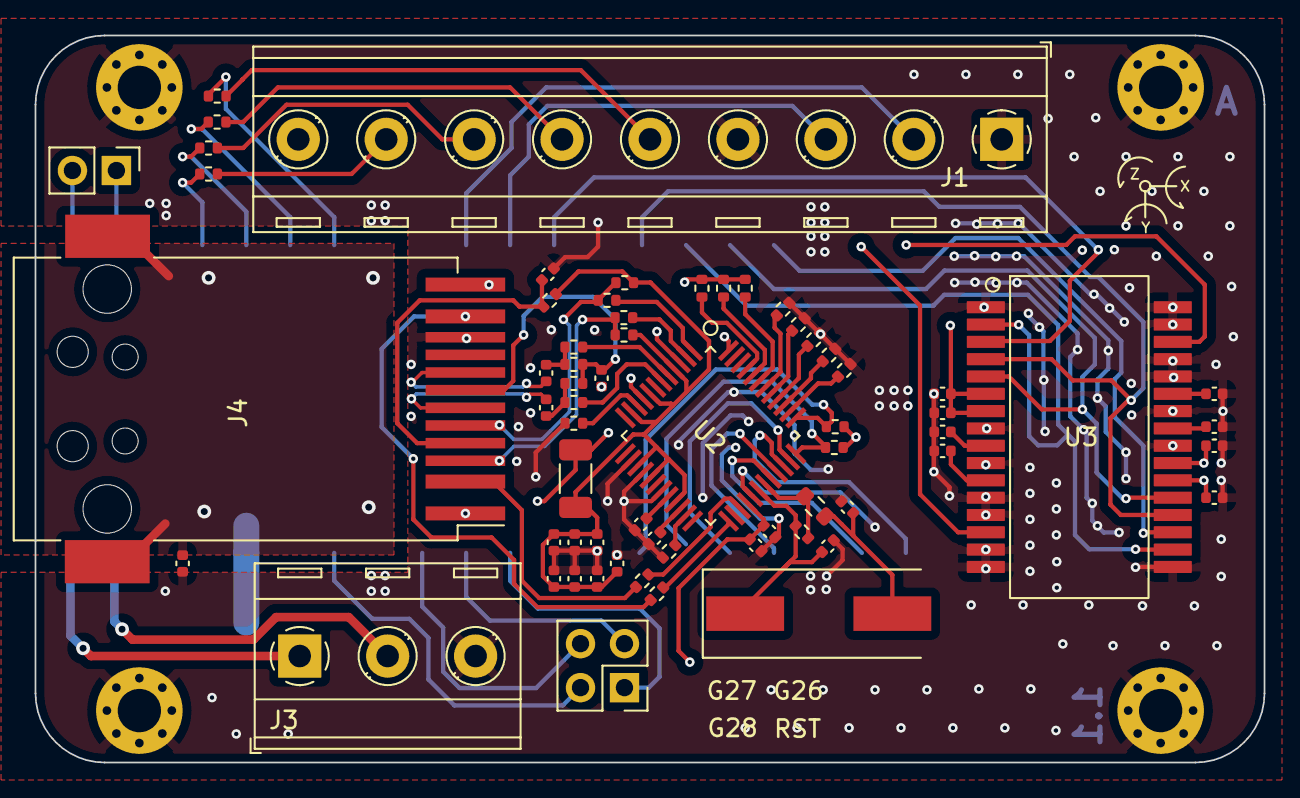
[picture p21: board pico_extension_v1_1.kicad_pcb from above]

Board: 4 copper layers, 71.0 x 42.0 mm, 69 parts (1 on the bottom side), 70 nets.
