oseiskar/CE-inertial/(commit log)

2022-09-25 Add schematics
2022-10-12 Add test/ folder and CMakeFile
    Maybe needed due to a bad CMakeLists.txt somewhere else (pico-sdk?)
2022-10-12 Tune CMakeLists.txt and main.c
    * import pico SDK from ENV variable
    * remove unused url helper
    * remove unused/nonexistent 'test' folder
2022-10-12 Fix/change pin numbers in scha63x_spi.c and tune debug prints
    [scha63x_spi.c]
