oseiskar/CE-inertial/(notices)

Notices in the files:
PCBs/custom/mcu/w5500-pico-evb/PinHeader_1x20_P2.54mm_Vertical.step:
Copyright (C) 2017, kicad StepUp
This work is licensed under the [Creative Commons CC-BY-SA 4.0 License](https://creativecommons.org/licenses/by-sa/4.0/legalcode),
with the following exception:
To the extent that the creation of electronic designs that use 'Licensed Material' can be considered to be 'Adapted Material',
You are free to use the library data in your own projects without the obligation to share your project files under this or any other license agreement.
PCBs/custom/terminal/TerminalBlock_Phoenix_MKDS-1,5-3-5.08_1x03_P5.08mm_Horizontal.step:
Copyright (C) 2020, kicad StepUp
PCBs/design-files/RPi-Pico/pico_extension_v1_1.kicad_pcb:
© 2022 Christian Kaarre
